KitWallace/TreeCare/README.md

# TreeCare

Code and issues for the Tree Care application:

https://treecarers.org.uk/
