KitWallace/TreeCare/assets/trecup.png

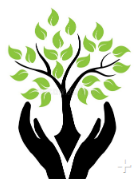
assets/trecup.png
