KitWallace/TreeCare/BOM.ods

Parts | model | supplier | # | cost | total
Container | Clip and Close 450ml | Bishopston Hardware | 1 | 2.80 | 2.80
Main board | TTGO T-Call V1.3 | BangGood | 1 | 11.22 | 11.22
Veroboard | 64 mm x 95mm | https://www.ebay.co.uk/itm/184162385556 | 1 | 1.25 | 1.25
Moisture sensor | V2.0 | https://www.ebay.co.uk/itm/402756086434 | 1 | 3.26 | 3.26
Temperature sensor | DS18B20 | https://www.ebay.co.uk/itm/274653634571 | 2 | 2.40 | 4.80
JST sockets and wired plugs | 3-pin 0.1 inch pitch | https://www.ebay.co.uk/itm/223969019137 | 3 | 0.25 | 0.75
SIM Card | PAYG SIM | GiffGaff/Things Mobile | 1 | 10.00 | 10.00
Battery Case | 2x 18650 case | https://www.ebay.co.uk/itm/333863352792 | 1 | 2.15 | 2.15
Battery | 18650 UltraFire Red 4200 | https://www.ebay.co.uk/itm/353434451133 | 2 | 5.00 | 10.00
IPEX antenna | replacement for supplied version | https://www.ebay.co.uk/itm/202090080000 | 1 | 1.19 | 1.19
sundries | sensor cables, wiring, pins and headers |  | 1 | 1.00 | 1.00
Total cost |  |  |  |  | 48.42
