KitWallace/TreeCare/(list of files, drawings)

Other design files:
arduino/SCH_moisture sensor-rev_2021-10-16.json
