KitWallace/TreeCare/arduino/configurationguide.odt

Purpose

To check that all sensors are working and that values required for conversion of raw sensor data are recorded in the attached form for entry into the server-side description.

Tools
You will need a digital voltmeter to check voltages on the board.

The board

These diagnostics assume you are using the v2 sensor base board. This board uses screw terminals for the sensor connections which provide voltage measuring points.


The script
Load the Arduino calibration script

https://github.com/KitWallace/TreeCare/blob/master/arduino/tree-sensor-calibrate-power-on.ino

This script supports testing and calibration of the sensors, including the onboard battery level sensor.

The script uses the same pins as the main sensor script but applies constant power to the power pins. It prints the current sensor values on the serial stream, cycling every 10 seconds.

MAC address

The device MAC address is used to identify the device on the server. Record this on the form.

Moisture sensor
The capacitive moisture sensor has three connections: ground, 3.3v and the output voltage which when the sensor is powered on, lies between 0 and something less than 3.3v.

Connect the sensor to its terminals on the board. Check that the voltage between ground and 3.3v is correct and indicates that the sensor is being powered on. Next check that the sensor is working by measuring the voltage on the output terminal when the sensor is in air and when immersed in water. These voltages should be around 3v for air and 1v for water. If they are not or are not repeatable, the sensor is faulty. We have had to return some sensors which have not passed this test.

If the sensor is outputting a sensible voltage, the sensor can be calibrated. Each sensor is slightly different so we need to establish the digital value (in millivolts) measured by the a2d converter on the esp32 chip for air ( 0% moisture) and water (100% moisture). These values will be average values and it is best to wait a minute or so for the sensor to stabilise before noting these values. The value for air should be about 3000, that for water about 1000.

Record the two values on the calibration form. This data will be used to create the device description on the server.

Temperature sensors.

These do not require calibration but they do need to be distinguished so that they can be installed correctly on site. This is done by attaching a plastic tag to each marked ‘AIR’ and ‘WATER’

Attach one of the sensors to one of the temperature sensor terminal blocks. Check that the sensor has power.

The output is digital so would need a signal meter to check but these are very reliable devices. Check that the reported temperature is appropriate and that it responds when warmed up in the hand. Tag this sensor as whichever device (air or soil) is reporting.

Repeat for the second sensor. To distinguish between the sensors when they are both connected, just warm one sensor to see which responds.

Check the form when the sensors have been physically marked.

Battery sensor (TDB)

The battery level allows us to predict when the battery will fail, but we need to establish the value of a fully charged battery pack.

Put two fully charged batteries in the holder and with the board disconnected from usb power, measure the voltage across the battery pack. Plug the usb in and measure again. If the battery is fully charged they should be the same (??) . Record this base voltage on the form



Form

Mac address:

Moisture sensor air:

Moisture sensor water:

Air temperature tagged:

Soil temperature tagged:

Fully charged battery reading:
