KitWallace/TreeCare/(threads)

Thread 2 (2021-03-19):

Wake up from deep sleep on battery

KitWallace, 2021-03-19:
Ive now plugged in the 18650 batteries and whilst it runs fine, it doesn't wake from deep sleep on battery - It did used to a fresh LiPo.  There seems to be some stuff on the ESP32 forum - maybe its the power pulse on wake-up?

https://www.esp32.com/viewtopic.php?t=19335&p=72346

Need to understand deep sleep better.

KitWallace, 2021-03-19:
I should add that this is a problem on the Wifi version  - more of a problem if it occurs on the GSM version

KitWallace, 2021-03-20:
same problem with the same code on the V1.4 board -  needs a hard reset and voltage reported is 3.9  - sane thing if I just use delay - very puzzling

KitWallace, 2021-03-20:
Power management code needed for all on-battery usage  -  treat as solved

IanMitchell77, 2021-03-23:
@KitWallace ,
What was the power management code that fixed this?
I thought that using the 18650 batteries solved this?

Closed 2021-03-20.

Thread 4 (2021-05-06):

editor for device data

KitWallace, 2021-05-06:

KitWallace, 2022-01-19:
Descriptor file is too complex and unstable for a simple editor - given that only admin users will be do this , there is now a facility to download a device so it can be edited in an XML-aware editor (Notepad++ with CML plugin eg) and then upload - works OK

Closed 2022-01-19.

Thread 8 (2021-12-10):

parameterised validation

KitWallace, 2021-12-10:
min and max values for a reading as part of the profile so that invalid data can be flaged - eg missing temperature data

KitWallace, 2022-04-30:
each field has min and max for validation

Closed 2022-04-30.
