KitWallace/TreeCare/arduino/tree-sensor-GSM-3.ino

/*
  Rui Santos
  Complete project details at https://RandomNerdTutorials.com/esp32-sim800l-publish-data-to-cloud/
  
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
  adapted by  kit wallace for use in remote moisture and temperature  sensing with help from Ian Mitchell
  
*/

// configuration constants

//  GPRS credentials 
const char apn[]      = "uk.lebara.mobi"; 
const char gprsUser[] = "wap"; 
const char gprsPass[] = "wap"; 

// SIM card PIN (leave empty, if not defined)
const char simPIN[]   = ""; 

// Server details
const char server[] = "kitwallace.co.uk"; 
const char resource[] = "/logger/log-data.xq";   
const int  port = 80;           

String appid = "1418";   // logger pin - change this 
String device = "Tree2";   // change this for a different location - server knows what tree this sensor attached to so no need for changes in the field.

// GPIO sensor power 
#define POWER 13

// moisture sensor
#define moisture_A2D A3

const int AirValue = 3199;   
const int WaterValue = 1207;  

// Data wire is on Pin 14 (I/O pin) with added 4.7K pullup)
#define ONE_WIRE_BUS 14

// battery monitoring
#define battery_ADC 35

// refresh interval
#define TIME_TO_SLEEP  60*60        /* Time ESP32 will go to sleep (in seconds)  */

// end configuration
// TTGO T-Call pins
#define MODEM_RST            5
#define MODEM_PWKEY          4
#define MODEM_POWER_ON       23
#define MODEM_TX             27
#define MODEM_RX             26
#define I2C_SDA              21
#define I2C_SCL              22

// Moisture sensor
// sensor reading fluctuates so I use the median of 2n+1 readings as a rubust central messure 

const int nReadings=7;  // must be odd
int readings[nReadings];
int reading_delay=10;
int get_moisture_pc() {
   for (int i=0;i < nReadings; i++) {
    int reading = analogRead(moisture_A2D);
    readings[i]=reading;
    delay(reading_delay);
   }
//   printArray(readings,nReadings);
   int soilMoistureValue = median(readings,nReadings);
//   Serial.print("median ");
//   Serial.println(soilMoistureValue);
   int soilMoisturePC = map(soilMoistureValue, AirValue, WaterValue, 0, 100);
   if (soilMoisturePC > 100 )  soilMoisturePC = 100; 
   if (soilMoisturePC <0 )  soilMoisturePC = 0;   
   return soilMoisturePC; 
}

//Bubble sort  - Its many years since I used this and I'm suitably ashamed but for 7 numbers performance ist an issue
void bubbleSort(int *a, int n)
{
 for (int i = 1; i < n; ++i)
 {
   int j = a[i];
   int k;
   for (k = i - 1; (k >= 0) && (j < a[k]); k--)
   {
     a[k + 1] = a[k];
   }
   a[k + 1] = j;
 }
}

int median (int *a,int n) {
// n odd
  int mid = n/2;
  bubbleSort(a,n);
  return a[mid];
}

void printArray(int *a, int n)
{
 for (int i = 0; i < n; i++)
 {
   Serial.print(a[i]);
   Serial.print(' ');
 }
 Serial.println();
}

// temperature sensor
#include <OneWire.h>
#include <DallasTemperature.h>


// Setup a oneWire instance to communicate with any OneWire devices
OneWire oneWire(ONE_WIRE_BUS);

// Pass our oneWire reference to Dallas Temperature sensor 
DallasTemperature sensors(&oneWire);


// Set serial for debug console (to Serial Monitor, default speed 115200)
#define SerialMon Serial
// Set serial for AT commands (to SIM800 module)
#define SerialAT Serial1

// Configure TinyGSM library
#define TINY_GSM_MODEM_SIM800      // Modem is SIM800
#define TINY_GSM_RX_BUFFER  1024  // Set RX buffer to 1Kb

// Define the serial console for debug prints, if needed
//#define DUMP_AT_COMMANDS

#include <Wire.h>
#include <TinyGsmClient.h>

#ifdef DUMP_AT_COMMANDS
  #include <StreamDebugger.h>
  StreamDebugger debugger(SerialAT, SerialMon);
  TinyGsm modem(debugger);
#else
  TinyGsm modem(SerialAT);
#endif

// I2C for SIM800 (to keep it running when powered from battery)
TwoWire I2CPower = TwoWire(0);


// TinyGSM Client for Internet connection
TinyGsmClient client(modem);

#define uS_TO_S_FACTOR 1000000ULL     /* Conversion factor for micro seconds to seconds - cast as ULL to allow long sleeps  */

#define IP5306_ADDR          0x75
#define IP5306_REG_SYS_CTL0  0x00

bool setPowerBoostKeepOn(int en){
  I2CPower.beginTransmission(IP5306_ADDR);
  I2CPower.write(IP5306_REG_SYS_CTL0);
  if (en) {
    I2CPower.write(0x37); // Set bit1: 1 enable 0 disable boost keep on
  } else {
    I2CPower.write(0x35); // 0x37 is default reg value
  }
  return I2CPower.endTransmission() == 0;
}

void setup() {
  // Set serial monitor debugging window baud rate to 115200
  SerialMon.begin(115200);

  pinMode(POWER,OUTPUT);
 
  //one wire begin
  sensors.begin();
  
  // Start I2C communication
  I2CPower.begin(I2C_SDA, I2C_SCL, 400000);

  // Keep power when running from battery
  bool isOk = setPowerBoostKeepOn(1);
  SerialMon.println(String("IP5306 KeepOn ") + (isOk ? "OK" : "FAIL"));

  // Set modem reset, enable, power pins
  pinMode(MODEM_PWKEY, OUTPUT);
  pinMode(MODEM_RST, OUTPUT);
  pinMode(MODEM_POWER_ON, OUTPUT);
  digitalWrite(MODEM_PWKEY, LOW);
  digitalWrite(MODEM_RST, HIGH);
  digitalWrite(MODEM_POWER_ON, HIGH);

  // Set GSM module baud rate and UART pins
  SerialAT.begin(115200, SERIAL_8N1, MODEM_RX, MODEM_TX);
  delay(3000);

  // Restart SIM800 module, it takes quite some time
  // To skip it, call init() instead of restart()
  SerialMon.println("Initializing modem...");
  modem.restart();
  // use modem.init() if you don't need the complete restart

  // Unlock your SIM card with a PIN if needed
  if (strlen(simPIN) && modem.getSimStatus() != 3 ) {
    modem.simUnlock(simPIN);
  }

  // Configure the wake up source as timer wake up  
  esp_sleep_enable_timer_wakeup(TIME_TO_SLEEP * uS_TO_S_FACTOR);
}

void loop() {
   int start = millis();
   digitalWrite(POWER,HIGH); // power on the sensors
   delay(200);

// get sensor data
   int moisture_pc = get_moisture_pc();
// get battery level
   float battery_voltage = analogRead(battery_ADC) *2.0 / 1135;
// get temperature
   sensors.requestTemperatures();
   float temp_C = sensors.getTempCByIndex(0);

   digitalWrite(POWER,LOW); // power off the sensors

// send data
   SerialMon.print("Connecting to APN: ");
   SerialMon.print(apn);
   if (!modem.gprsConnect(apn, gprsUser, gprsPass)) {
       SerialMon.println(" fail");
   }
   else {
      SerialMon.println(" OK");
      SerialMon.print("Connecting to ");
      SerialMon.print(server);
      if (!client.connect(server, port)) {
         SerialMon.println(" fail");
      }
      else {
         SerialMon.println(" OK");  
         int run_ms = millis() - start;   
  // get signal quality
   int signal_quality = modem.getSignalQuality();          

  // make URL      
   String httpRequestData = "_appid=" + appid + "&_device="+ device +"&moisture-pc="+ moisture_pc +"&battery-voltage="+battery_voltage+"&temp-C="+temp_C + "&signal-quality=" + signal_quality+"&run_ms="+run_ms;
   SerialMon.println(httpRequestData);

  // post data   
         client.print(String("POST ") + resource + " HTTP/1.1\r\n");
         client.print(String("Host: ") + server + "\r\n");
         client.println("Connection: close");
         client.println("Content-Type: application/x-www-form-urlencoded");
         client.print("Content-Length: ");
         client.println(httpRequestData.length());
         client.println();
         client.println(httpRequestData);

         unsigned long timeout = millis();
         while (client.connected() && millis() - timeout < 10000L) {
           // Print available data (HTTP response from server)
            while (client.available()) {
               char c = client.read();
               SerialMon.print(c);
               timeout = millis();
            }
         }
         SerialMon.println();
         
         // Close client and disconnect
         client.stop();
         SerialMon.println("Server disconnected");
         modem.gprsDisconnect();
         SerialMon.println("GPRS disconnected");
       }
   }
// Put ESP32 into deep sleep mode (with timer wake up)
    esp_deep_sleep_start();
//  delay(TIME_TO_SLEEP*1000);
}
