KitWallace/TreeCare/(commit log)

2021-02-14 Create moisture-sensor.ino
    Moisure sensor based on ESP32 + GSM board + capacitive moisture sensor
2021-04-29 Create tree-sensor-GSM-3
2021-07-09 Pin assignments in line with V3
2021-10-17 Create sensor-calibrate-comms.ino
    test bench calibration of moisture and temperature sensors with reporting via GSM to the config device on the dashboard - includes reporting the board MAC address and the SIM card CCID
2021-10-18 Moisure sensor board v1
    [SCH_moisture sensor-rev_2021-10-16.json]
2021-10-30 increase moisture sensor warmup time; fixed run_ms bug
    [tree-sensor-v6.ino]
2023-09-16 Create tree-sensor-6.7.1.ino
    minor correction to startup procedure
    [tree-sensor-6.7.1.ino]
